wk200202/My_H7_Pi/README.md

#### 版本信息

----

2024-11-10

添加QSPI-W25Q256驱动，使用MDMA驱动，Cache问题待解决

添加Timer定时器，待整理

----
