wk200202/My_H7_Pi/Doc/HARDWARE/v1.2/BOM.xlsx

No. | Quantity | Comment | Designator | Footprint | Value | Manufacturer Part | Manufacturer | Supplier Part | Supplier
1 | 2 | TS-1010-B-A | BOOT,RST | KEY-SMD_TX-1010-X-X |  | TS-1010-B-A | XKB Connectivity(中国星坤) | C318941 | LCSC
2 | 3 | 2.2uF | C1,C2,C11 | C0402_S | 2.2uF
3 | 35 | 100nF | C3,C9,C10,C12,C19,C23,C25,C26,C27,C28,C29,C30,C31,C32,C33,C34,C35,C36,C37,C38,C39,C40,C41,C42,C43,C44,C45,C47,C60,C61,C62,C63,C64,C65,C66 | C0402_S | 100nF
4 | 1 | 1uF | C4 | C0402_S | 1uF
5 | 2 | 22pF | C5,C13 | C0402 | 22pF
6 | 5 | 10uF | C6,C14,C49,C79,C80 | C0402 | 10uF
7 | 5 | 4.7uF | C7,C8,C93,C102,C103 | C0402 | 4.7uF
8 | 41 | 100nF | C15,C16,C24,C48,C50,C51,C52,C53,C54,C55,C56,C57,C58,C59,C67,C68,C70,C72,C73,C78,C85,C86,C87,C88,C89,C90,C94,C97,C98,C99,C100,C101,C104,C105,C110,C111,C112,C113,C114,C115,C116 | C0402 | 100nF
9 | 2 | 9pF | C17,C18 | C0402 | 9pF | CL10C120JB8NNNC | SAMSUNG(三星) |  | LCSC
10 | 4 | 12pF | C20,C21,C91,C92 | C0402 | 12pF | 0805CG9R0C500NT | FH(风华) |  | LCSC
11 | 2 | 10uF | C22,C46 | C0402_S | 10uF
12 | 2 | 220uF | C69,C71 | CAP-SMD_L6.0-W3.2-R-RD | 220uF | TAJC227K006RNJ | Kyocera AVX | C7216 | LCSC
13 | 6 | 1uF | C74,C75,C76,C77,C82,C83 | C0402 | 1uF
14 | 1 | 220pF | C81 | C0402 | 220pF
15 | 1 | 220uF | C84 | CAP-SMD_BD6.3-L6.6-W6.6-FD | 220uF | RVT220UF16V67RV0015 | KNSCHA(科尼盛) | C2887273 | LCSC
16 | 2 | 20pF | C95,C96 | C0402 | 20pF | 0805CG9R0C500NT | FH(风华) |  | LCSC
17 | 2 | 22pF | C106,C107 | C0402 | 22pF | 0805CG9R0C500NT | FH(风华) |  | LCSC
18 | 1 | 10nF | C108 | C0603 | 10nF
19 | 1 | 3.3nF | C109 | C0603 | 3.3nF
20 | 1 | PJ-327A 5JJ | CN1 | AUDIO-SMD_PJ-327A5JJ |  | PJ-327A 5JJ | SHOU HAN(首韩) | C668605 | LCSC
21 | 1 | BAT54C-KL3 | D1 | SOT-23-3_L2.9-W1.3-P1.90-LS2.4-BR |  | BAT54C-KL3 | ZRE(治润) | C779698 | LCSC
22 | 3 | TYPE-C16PIN | DAPLink,ESP USB,USB | USB-SMD_TYPE-C16PIN |  | TYPE-C16PIN |  | C9900000202 | LCSC
23 | 1 | AFC01-S40FCA-00 | DISPLAY | FPC-SMD_P0.50-40P_FGS-XJ-H2.0 |  | AFC01-S40FCA-00 | JS(钜硕电子) | C262674 | LCSC
24 | 2 | TS3425BA | ESP BOOT,ESP RST | SW-SMD_4P-L4.2-W3.2-P2.15-LS4.6-1 |  | TS3425BA | SHOU HAN(首韩) | C2681476 | LCSC
25 | 4 | LED_RED | ESP_LED1,POWER,RX,TX | LED0603-RD |  | LED_RED | KENTO | C2286 | LCSC
26 | 1 | HY911105AE | Ethernet | RJ45-TH_HR911105A |  | HY911105AE | HANRUN(汉仁) | C69427 | LCSC
27 | 1 | BSMD0805-100-6V | F1 | F0805 |  | BSMD0805-100-6V | BHFUSE(佰宏) | C883112 | LCSC
28 | 3 | M3 | H1,H2,H3 | m3-0.8
29 | 2 | 2.2uH | L1,L2 | IND-SMD_L4.0-W4.0 | 2.2uH | SWPA4020S2R2MT | Sunlord(顺络) | C83423 | LCSC
30 | 4 | YI201209U121-5R0T | L3,L4,L5,L6 | L0805 |  | YI201209U121-5R0T | YJYCOIN(益嘉源) | C2971889 | LCSC
31 | 1 | AN9520-245 | L7 | ANT-SMD_L9.5-W2.1 |  | AN9520-245 | rainsun(霖昱微) | C99665 | LCSC
32 | 1 | AMB-O60G42-AB1 | MIC | MIC-TH_BD6.0-P1.90-D0.4-L-1 |  | AMB-O60G42-AB1 | Dragonstate(华龙) | C20200112 | LCSC
33 | 1 | TF-06A | MICRO SD CARD | TF-SMD_TF-06A |  | TF-06A | 韩国韩荣 | C693844 | LCSC
34 | 1 | FDV301N | Q1 | SOT-23_L2.9-W1.3-P1.90-LS2.4-BR |  | FDV301N | onsemi(安森美) | C15310 | LCSC
35 | 1 | W25Q256JVEIQ | QSPI_Flash1 | WSON-8_L6.0-W8.0-P1.27-BL-EP |  | W25Q256JVEIQ | WINBOND(华邦) | C2682312 | LCSC
36 | 6 | 5K1 | R1,R4,R7,R9,R69,R70 | R0402 | 5K1
37 | 2 | 100K | R2,R5 | R0402 | 100K
38 | 1 | 51K | R3 | R0402 | 51K
39 | 1 | 22K | R6 | R0402 | 22K
40 | 7 | 22R | R8,R10,R11,R12,R14,R15,R24 | R0402 | 22R
41 | 5 | 1K | R13,R16,R17,R21,R73 | R0402 | 1K
42 | 1 | 10K | R18 | C0402_S | 10K
43 | 22 | 10K | R19,R22,R23,R25,R26,R27,R28,R29,R30,R31,R32,R33,R34,R39,R40,R46,R50,R51,R58,R60,R67,R71 | R0402 | 10K
44 | 1 | 0R | R20 | C0402_S | 0R
45 | 7 | 4.7K | R35,R36,R37,R38,R41,R44,R49 | R0402 | 4.7K
46 | 6 | 0R | R42,R43,R47,R62,R63,R68 | R0402 | 0R
47 | 4 | 680R | R45,R56,R57,R65 | R0402 | 680R
48 | 1 | 47K | R48 | R0402 | 47K
49 | 4 | 49R9 | R52,R53,R54,R55 | R0402 | 49R9
50 | 1 | 6K8 | R59 | R0402 | 6K8
51 | 1 | 100R | R61 | R0402 | 100R
52 | 1 | 12K | R64 | R0402 | 12K
53 | 1 | 1M | R66 | R0402 | 1M
54 | 1 | 20K | R72 | R0603 | 20K
55 | 1 | LED-SMD-全彩四脚RGB黑面雾状-3528 | RGB | LED-SMD_FM-3528RGBA-HF |  |  |  | C9900014091 | LCSC
56 | 2 | WAFER-100W-6A | RS485,SPI | CONN-SMD_6P-P1.00_XUNPU_WAFER-100W-6P |  | WAFER-100W-6A | HANBO(汉博) | C2874473 | LCSC
57 | 1 | W9825G6KH-6 | SDRAM1 | TSOP-54_L22.2-W10.2-P0.80-LS11.8-BL |  | W9825G6KH-6 | WINBOND(华邦) | C62246 | LCSC
58 | 1 | vivo X5 SPK | SPEAKER | vivo X5 SPK
59 | 1 | KAN0741-0601M1 | SW1 | KEY-SMD_KAN0741-0601M1 |  | KAN0741-0601M1 | GANGYUAN(港源) | C231736 | LCSC
60 | 2 | Test-Point | TP1,TP2 | Test-Point-0.5mm
61 | 1 | TMI7003B | U1 | QFN-20_L3.0-W3.0-P0.40-BL-EP1.7 |  | TMI7003B | TMI(拓尔微) | C711925 | LCSC
62 | 1 | CH32V203F6P6 | U2 | TSSOP-20_L6.5-W4.4-P0.65-LS6.4-BL |  | CH32V203F6P6 |  | C3040880 | LCSC
63 | 1 | HS096T01H13 | U3 | LCD-SMD_HS096T01H13 |  | HS096T01H13 | HS(汉昇) | C18198246 | LCSC
64 | 1 | MPU6050 | U4 | QFN-24_L4.0-W4.0-P0.50-BL |  | MPU6050 |  | C9900042518 | LCSC
65 | 1 | SHT40-AD1B-R2 | U5 | DFN-4_L1.5-W1.5-P0.8-TL-EP |  | SHT40-AD1B-R2 | Sensirion(瑞士盛思锐) | C2909890 | LCSC
66 | 1 | WM8978GEFL/RV | U6 | VQFN-32_L5.0-W5.0-P0.50-TL-EP |  | WM8978GEFL/RV |  | C19177 | LCSC
67 | 1 | WS2811 | U7 | SOP-8_L4.9-W3.9-P1.27-LS6.0-BL | - | WS2811 | worldsemi | C114581 | LCSC
68 | 1 | SP3485EN-L/TR | U10 | SOIC-8_L5.0-W4.0-P1.27-LS6.0-BL |  | SP3485EN-L/TR | MaxLinear(迈凌) | C8963 | LCSC
69 | 1 | LP5907MFX-3.3/NOPB | U11 | SOT-23-5_L3.0-W1.7-P0.95-LS2.8-BR |  | LP5907MFX-3.3/NOPB | TI(德州仪器) | C80670 | LCSC
70 | 1 | DM9000AEP | U12 | LQFP-48_L7.0-W7.0-P0.50-LS9.0-BL |  | DM9000AEP | DAVICOM(联杰国际) | C14875 | LCSC
71 | 1 | USB3300-EZK | U13 | QFN-32_L5.0-W5.0-P0.50-BL-EP3.4 |  | USB3300-EZK | MICROCHIP(美国微芯) | C108954 | LCSC
72 | 1 | CH340E | U14 | MSOP-10_L3.0-W3.0-P0.50-LS5.0-BL |  | CH340E | WCH(南京沁恒) | C99652 | LCSC
73 | 1 | ESP32-D0WD | U15 | QFN-48_L5.0-W5.0-P0.35-BL-EP3.7 |  | ESP32-D0WD | ESPRESSIF(乐鑫) | C130167 | LCSC
74 | 1 | XM25QH128AHIG | U16 | SOP-8_L5.3-W5.3-P1.27-LS8.0-BL |  | XM25QH128AHIG | XMC(武汉新芯) | C328463 | LCSC
75 | 2 | TBD | U17,U18 | C0201 |  | TBD |  | C9900017648 | LCSC
76 | 1 | TBD | U19 | L0201 |  | TBD |  | C9900009767 | LCSC
77 | 1 | STM32H743XIH6 | U20 | TFBGA-265_L14.0-W14.0-P0.80-TL_STM32H743XIH6 |  | STM32H743XIH6 | ST(意法半导体) | C114407 | LCSC
78 | 1 | AF 14.0 CC-T | USB HS | USB-A-TH_AF14.0CC-T |  | AF 14.0 CC-T | SHOU HAN(首韩) | C456020 | LCSC
79 | 2 | 25MHz | X1,X3 | OSC-SMD_4P-L3.2-W2.5-BL | 25MHz | X322525MOB4SI | YXC(扬兴晶振) | C9006 | LCSC
80 | 1 | 32.768kHz | X2 | FC-135R_L3.2-W1.5 | 32.768kHz | Q13FC1350000400 | EPSON(爱普生) | C32346 | LCSC
81 | 1 | 24MHz | X4 | OSC-SMD_4P-L3.2-W2.5-BL | 24MHz | X322525MOB4SI | YXC(扬兴晶振) |  | LCSC
82 | 1 | 40MHz | X5 | OSC-SMD_4P-L3.2-W2.5-BL | 40MHz | X322525MOB4SI | YXC(扬兴晶振) |  | LCSC
