wk200202/My_H7_Pi/Doc/HARDWARE/v1.2/SCH.pdf

# 32M SDARM 32位宽 32M QSPI FLash RGB888 40Pin接口 0.96寸 LCD MicroSD卡 DM9000APE 百兆网口 USB3300 USB_PHY 480Mbps ESP32 SPI+UART IIS WM9878 = 3.5mm earphone + vivo K5 Speaker 板载DAPlink 支持串口

# 五向开关

# RGB LED

# STM32H743XIH6

# LTDC RGB666 FMC SDRAM FMC DM9000APE SDMMC MicroSD SPI LCD SPI ESP32 SPI RP2040 UART ESP32 UART Debug UART RS485

STM32H743XIH6_Core | POWER

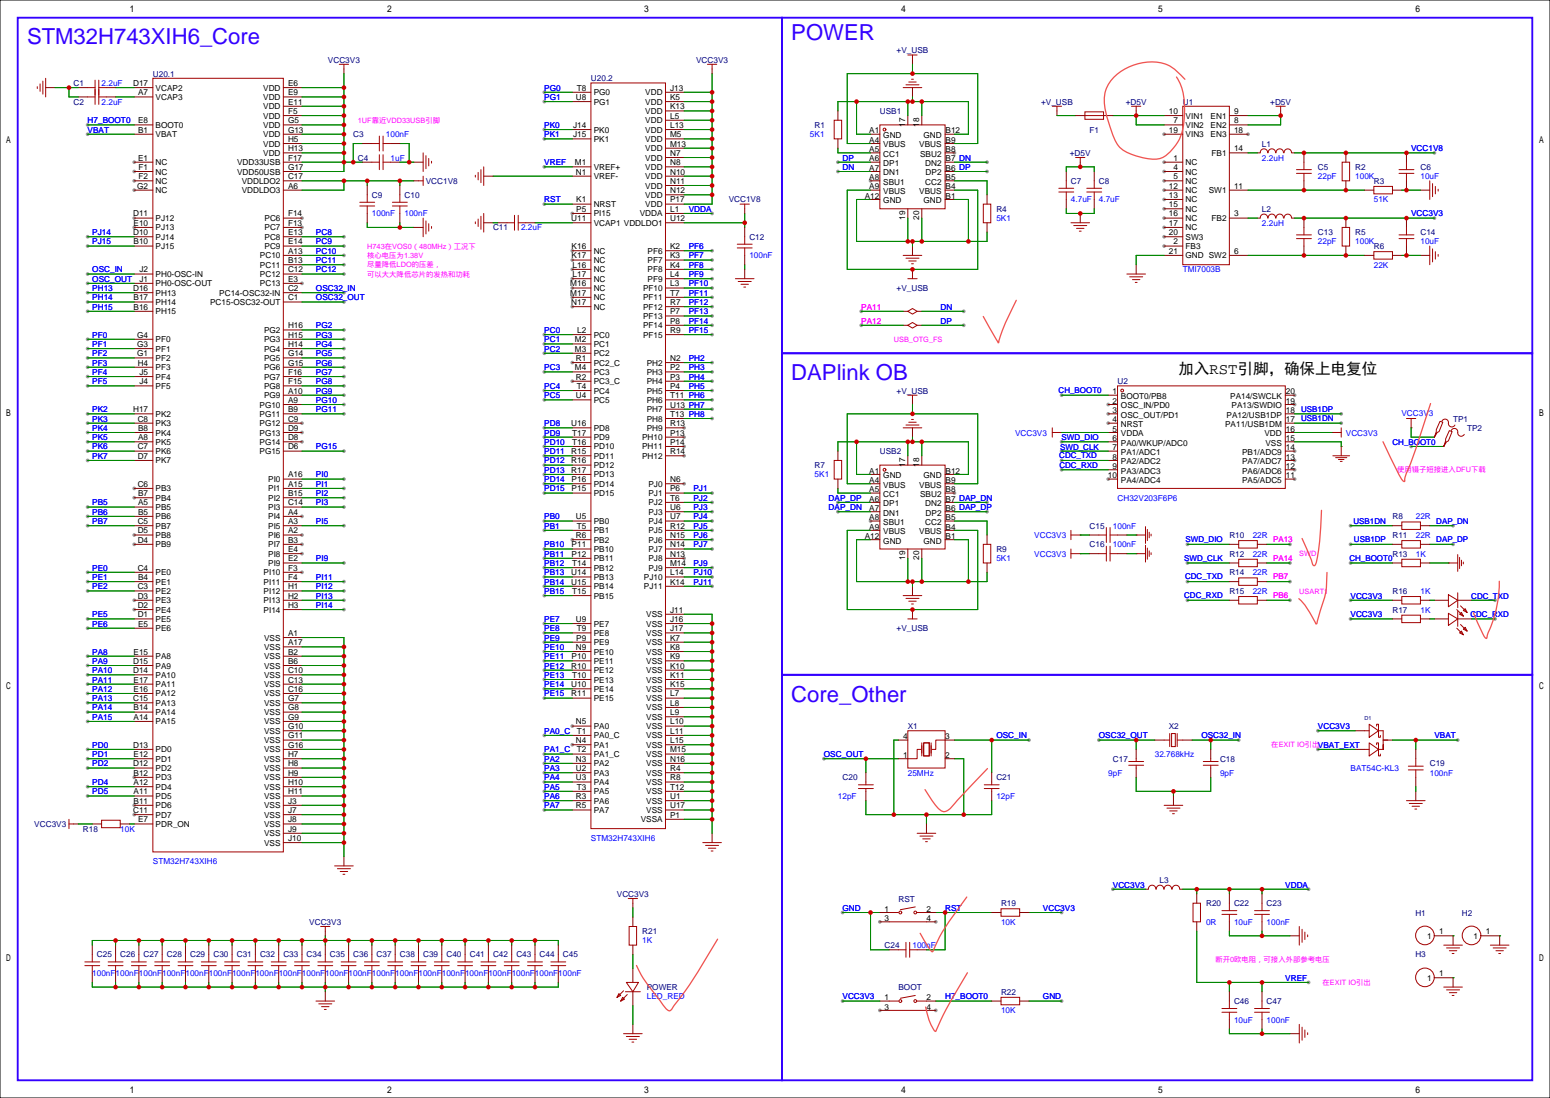
[picture p1: page 2]

VSS G16
VSS H11 VSS H10 VSS H9 VSS H8 VSS H7

VSS J3
VSS J10 VSS J9 VSS J8 VSS J7

SDRAM | MicroSD

# TFT LCD 0.96 inch

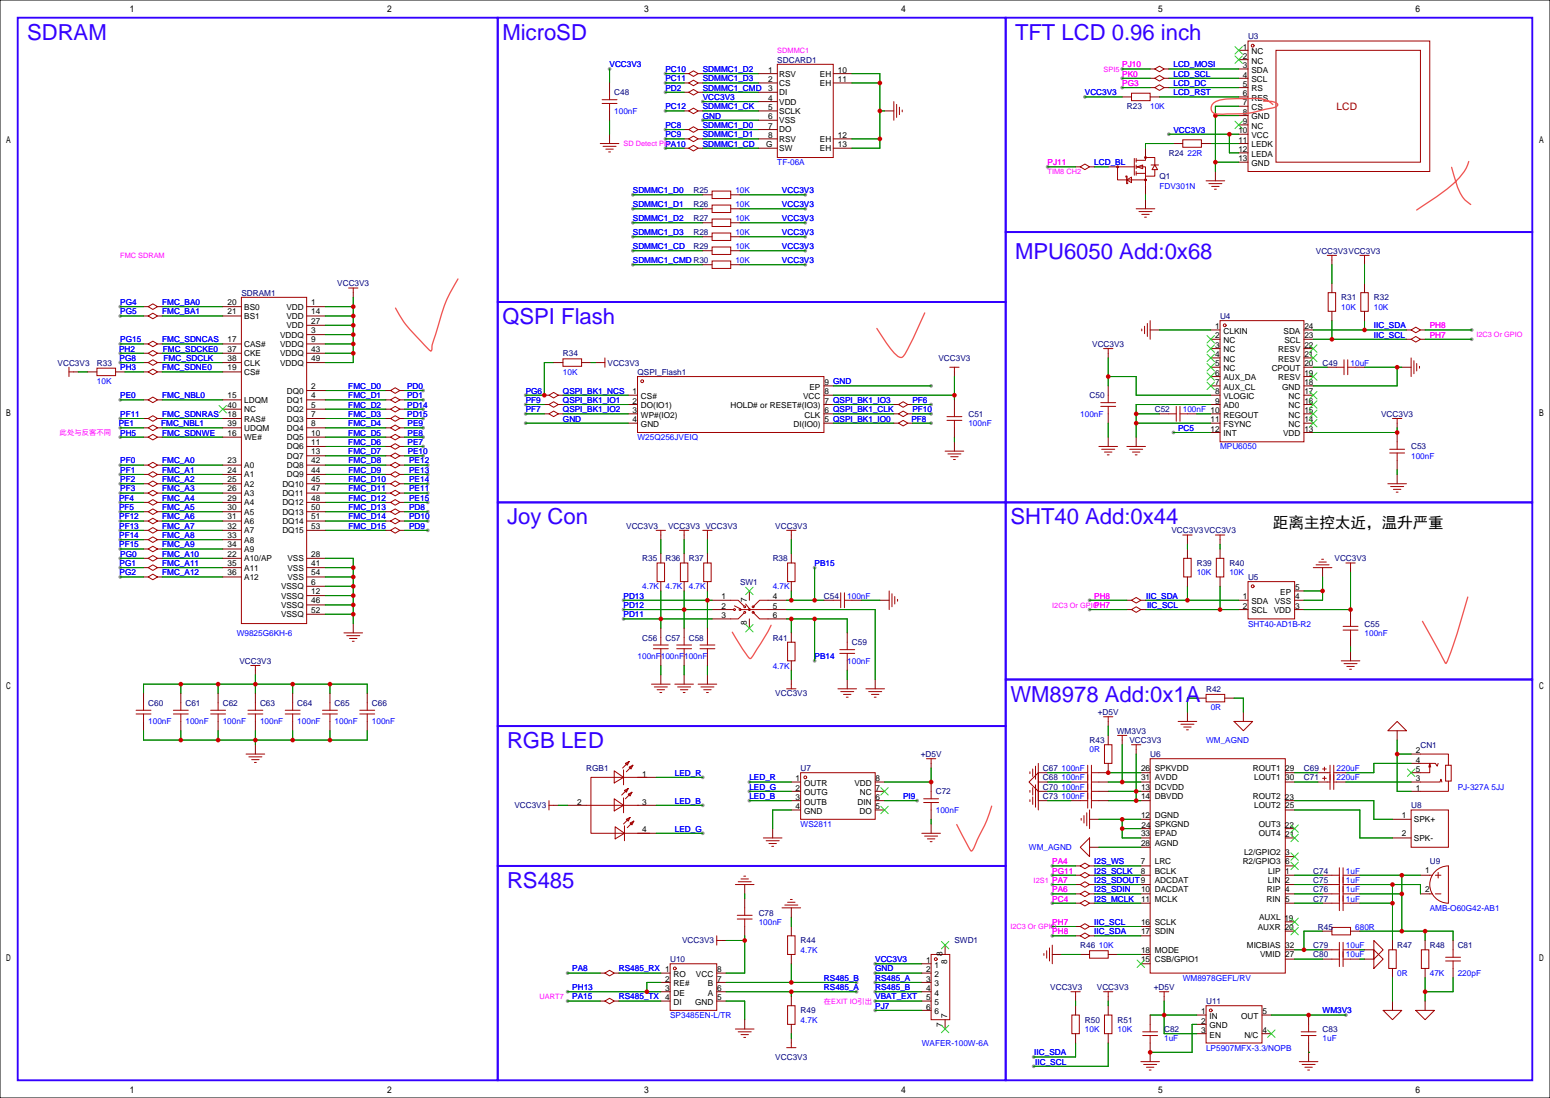
[picture p2: page 3]

# Ethernet PHY

# RGB LCD——AT070NT83

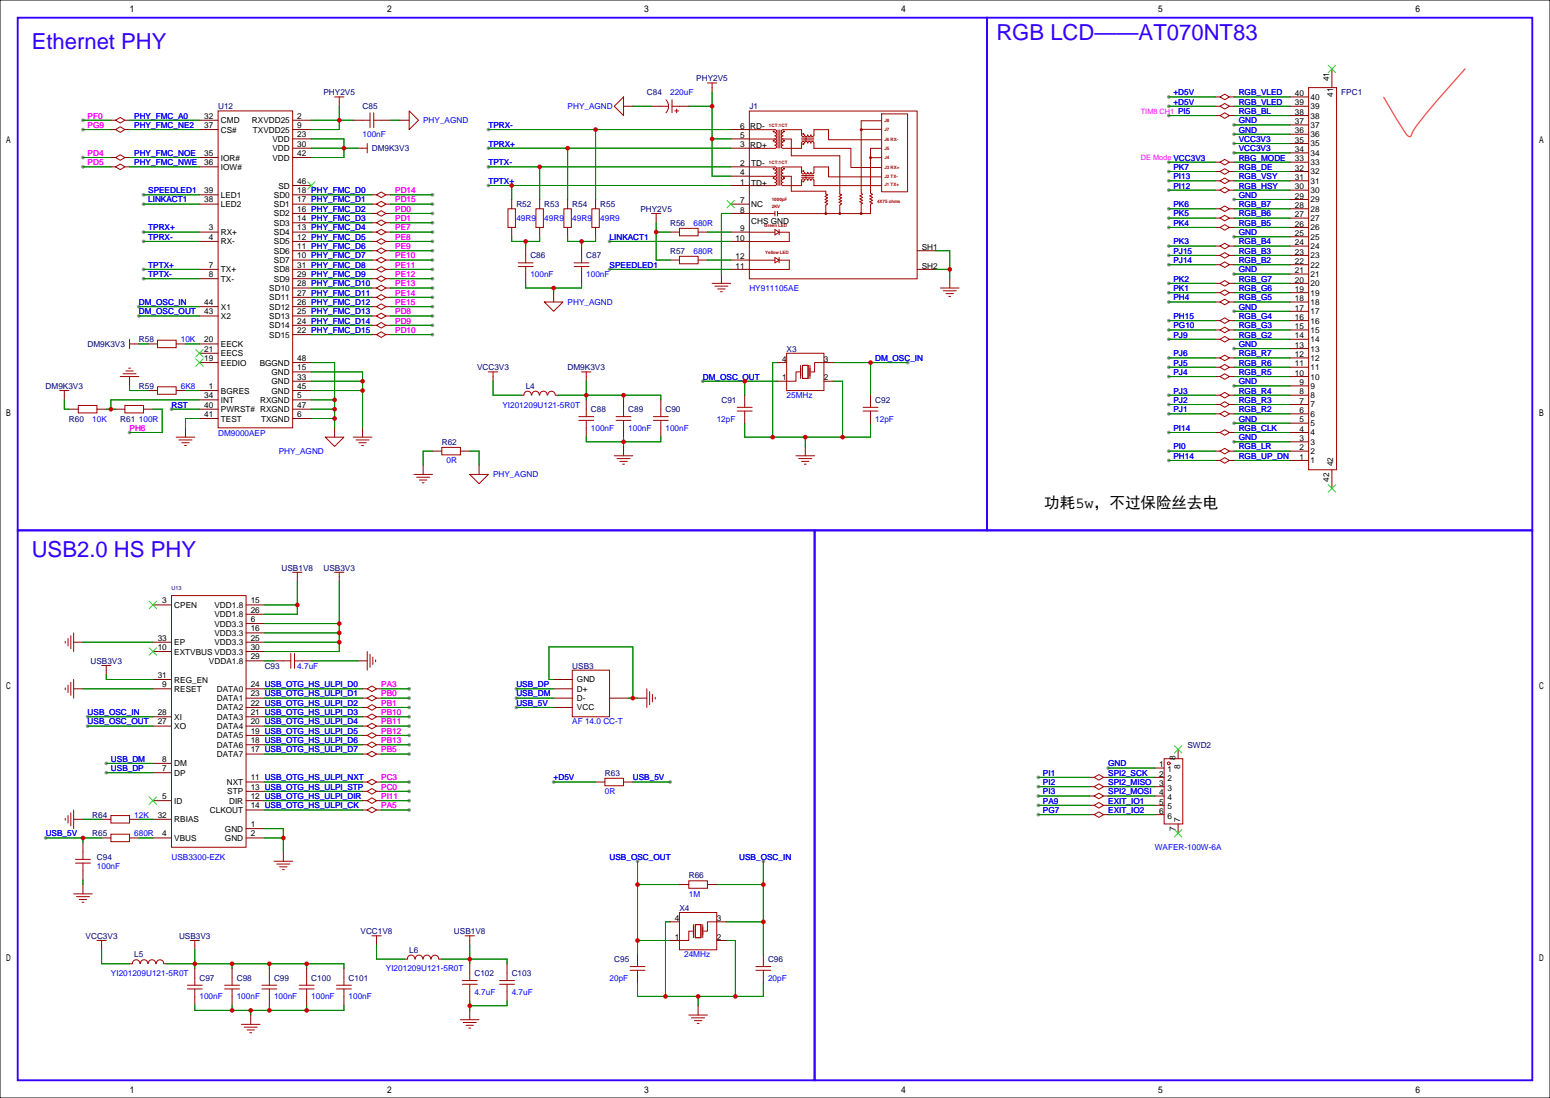
[picture p3: page 4]

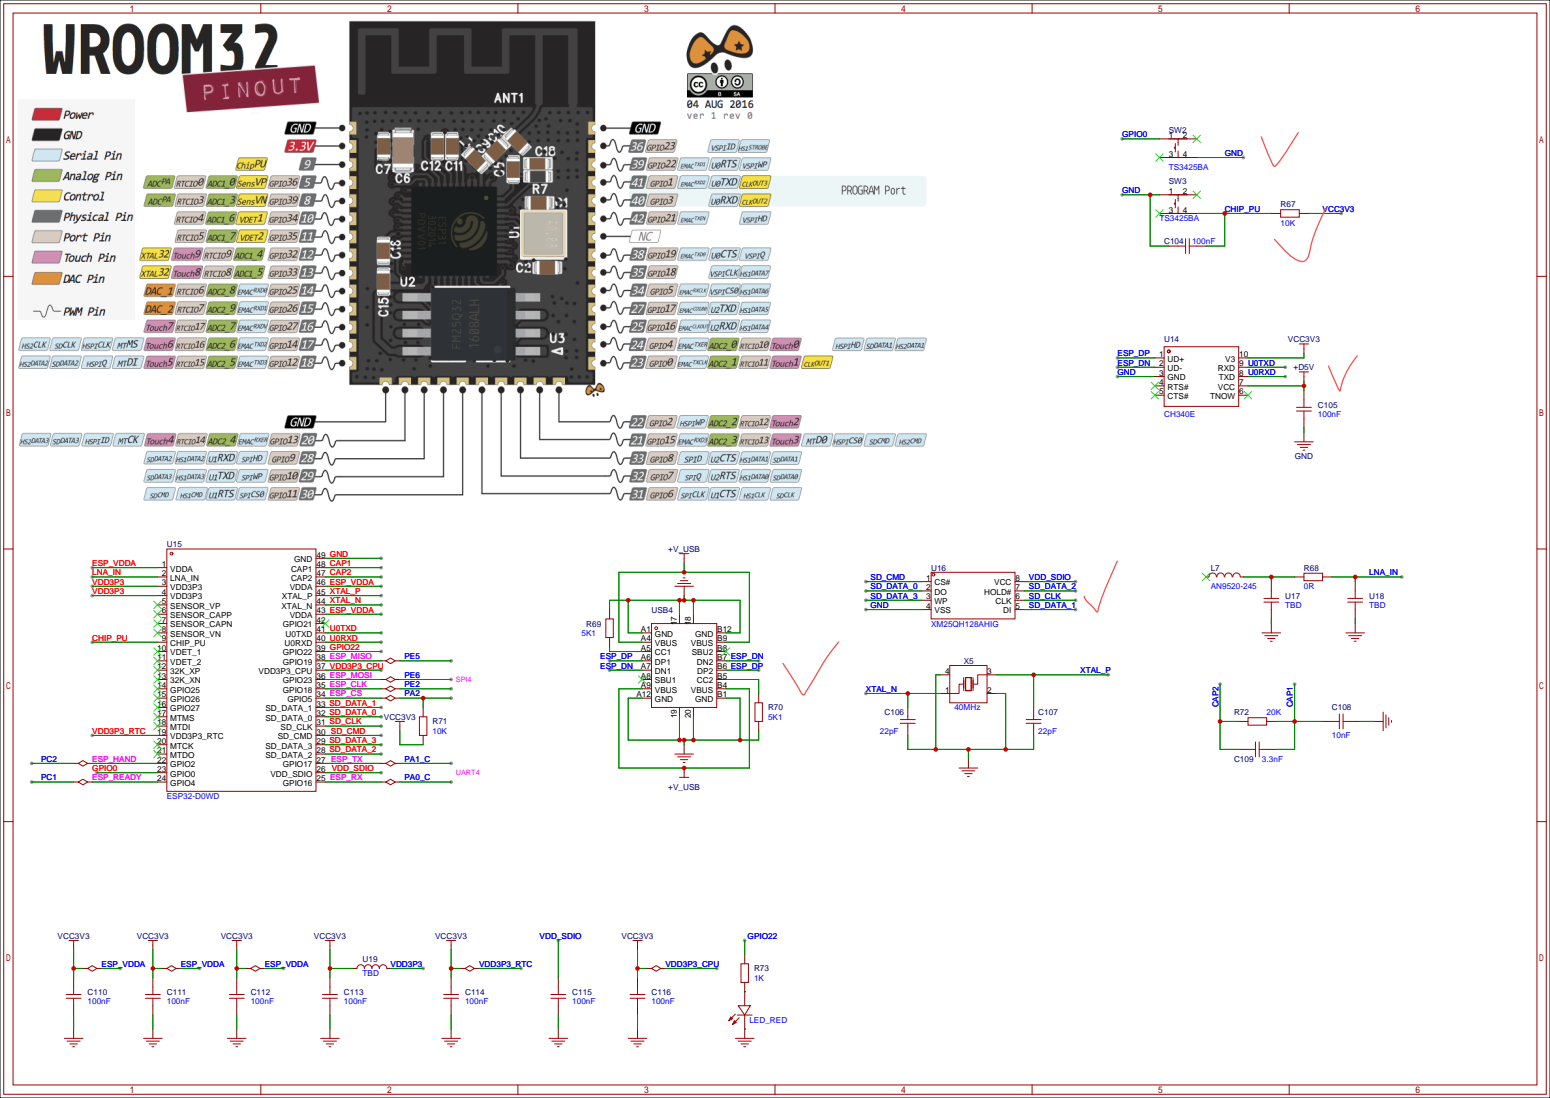
[picture p4: page 5]
