wk200202/My_H7_Pi/Doc/HARDWARE/v1.2/PCB.pdf

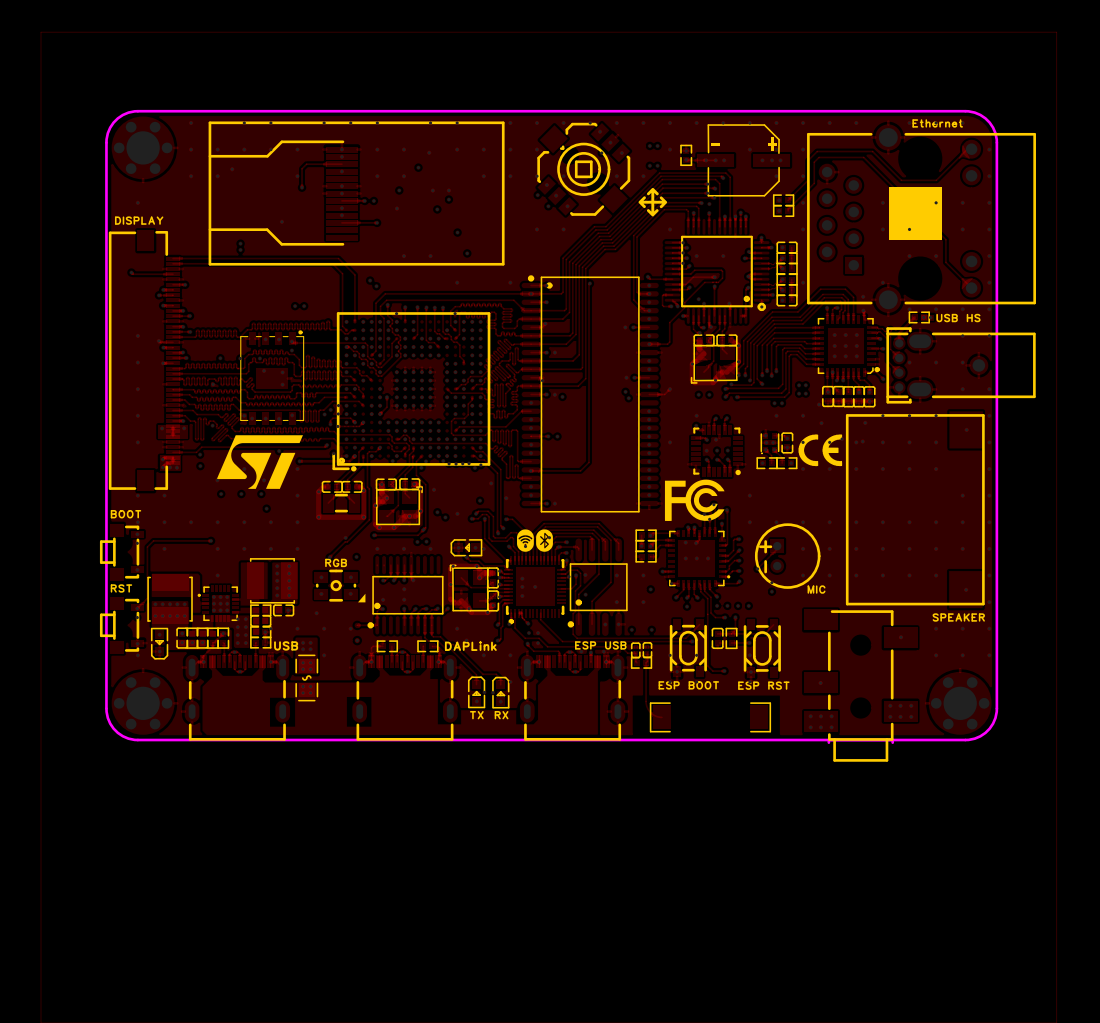
[picture p5: page 1]

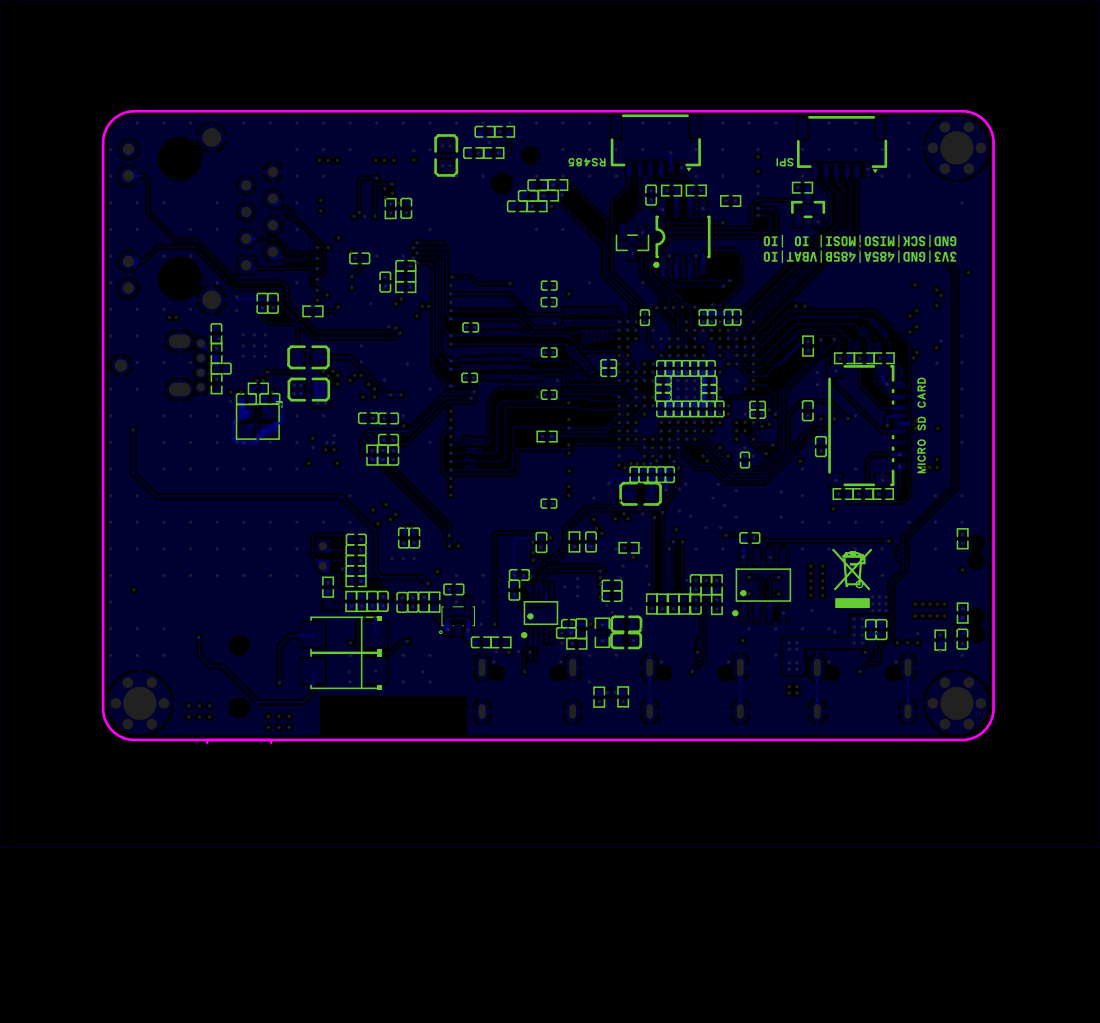
[picture p6: page 2]

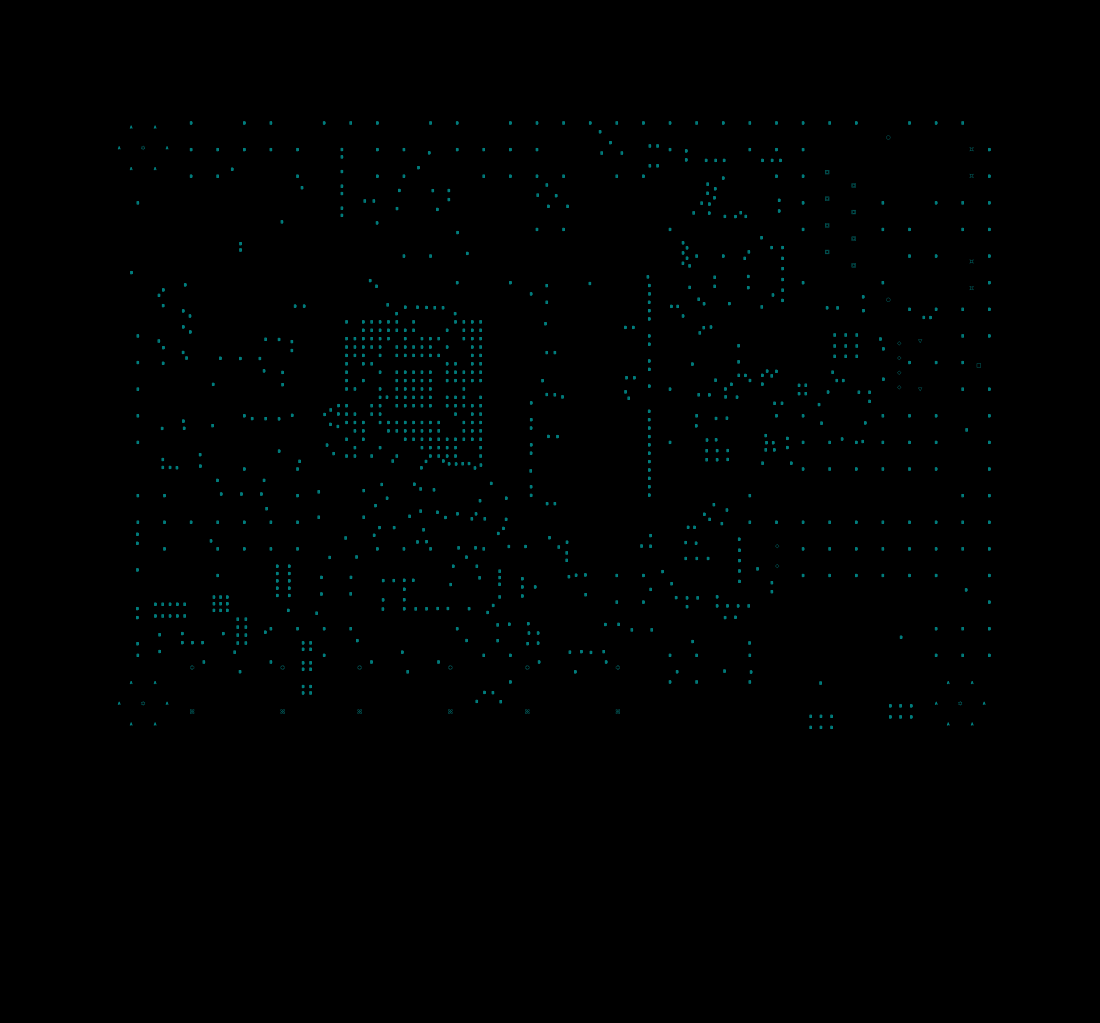
[picture p7: page 3]
