wk200202/My_H7_Pi/User/BSP/inc/bsp_iic.h

#ifndef __BSP_IIC_H
#define __BSP_IIC_H

/*
**************************************************************************
*	                          宏定义
**************************************************************************
*/

#define IIC_SCL_GPIO_PORT GPIOH
#define IIC_SCL_GPIO_PIN  GPIO_PIN_7
#define IIC_SCL_GPIO_CLK_ENABLE()     \
    do {                              \
        __HAL_RCC_GPIOH_CLK_ENABLE(); \
    } while (0) /* PB口时钟使能 */

#define IIC_SDA_GPIO_PORT GPIOH
#define IIC_SDA_GPIO_PIN  GPIO_PIN_8
#define IIC_SDA_GPIO_CLK_ENABLE()     \
    do {                              \
        __HAL_RCC_GPIOH_CLK_ENABLE(); \
    } while (0) /* PB口时钟使能 */

#define IIC_SCL(x)                                                                                                                                         \
    do {                                                                                                                                                   \
        x ? HAL_GPIO_WritePin(IIC_SCL_GPIO_PORT, IIC_SCL_GPIO_PIN, GPIO_PIN_SET) : HAL_GPIO_WritePin(IIC_SCL_GPIO_PORT, IIC_SCL_GPIO_PIN, GPIO_PIN_RESET); \
    } while (0) /* SCL */

#define IIC_SDA(x)                                                                                                                                         \
    do {                                                                                                                                                   \
        x ? HAL_GPIO_WritePin(IIC_SDA_GPIO_PORT, IIC_SDA_GPIO_PIN, GPIO_PIN_SET) : HAL_GPIO_WritePin(IIC_SDA_GPIO_PORT, IIC_SDA_GPIO_PIN, GPIO_PIN_RESET); \
    } while (0) /* SDA */

#define IIC_READ_SDA HAL_GPIO_ReadPin(IIC_SDA_GPIO_PORT, IIC_SDA_GPIO_PIN) /* 读取SDA */

/*
**************************************************************************
*	                          变量声明
**************************************************************************
*/

/*
**************************************************************************
*	                          函数声明
**************************************************************************
*/

void bsp_iic_init(void);
void iic_start(void);
void iic_stop(void);
void iic_ack(void);
void iic_nack(void);
uint8_t iic_wait_ack(void);
void iic_send_byte(uint8_t txd);
uint8_t iic_read_byte(unsigned char ack);

#endif   // __BSP_IIC_H
