wk200202/My_H7_Pi/User/BSP/inc/bsp_sht40.h

#ifndef _BSP_SHT40_H_
#define _BSP_SHT40_H_

/***************************************************************************
*	                           宏定义
***************************************************************************/

#define SHT40_I2C_WRITE (0)
#define SHT40_I2C_READ  (1)

#define SHT40_INQUIRE_CNT (500)
#define SHT40_ADDR        (0x44)

/***************************************************************************
*	                          变量声明
***************************************************************************/

/***************************************************************************
*	                          函数声明
***************************************************************************/

int read_sht40_data(float *temp, float *humi);

#endif   // _BSP_SHT40_H_
