wk200202/My_H7_Pi/(commit log)

2024-11-10 add hardware and readme
    [BOM.xlsx]
2024-11-11 add soft Timer bsp
